KhachaturovIlya/Number-Generator/3Д/общий эскиз ГСЧ.pdf

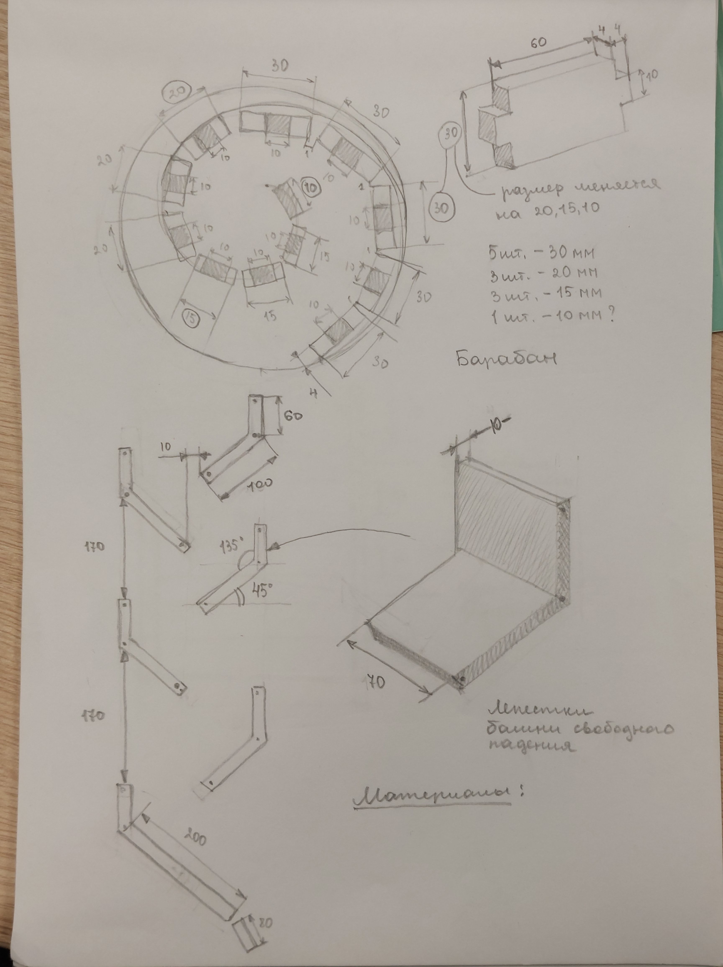
[picture p1: page 1]
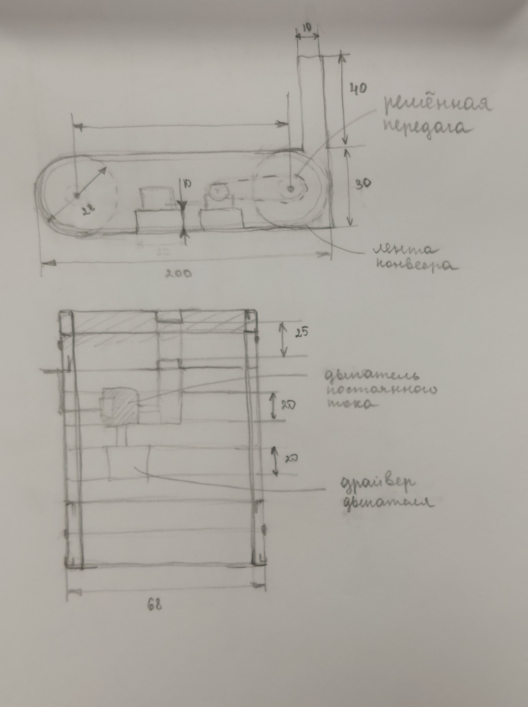
[picture p2: page 2]
