KhachaturovIlya/Number-Generator/3Д/Рендер барабана.pdf

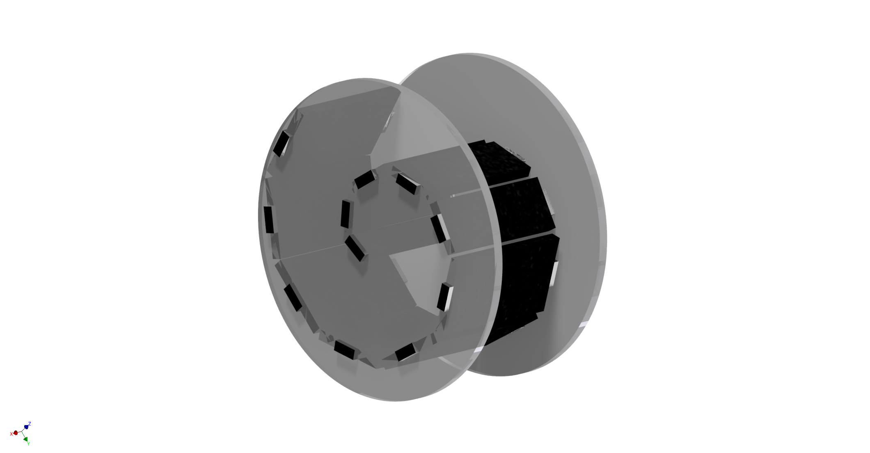
[picture p3: page 1]
