KhachaturovIlya/Number-Generator/3Д/Рендер конвейера в разрез.pdf

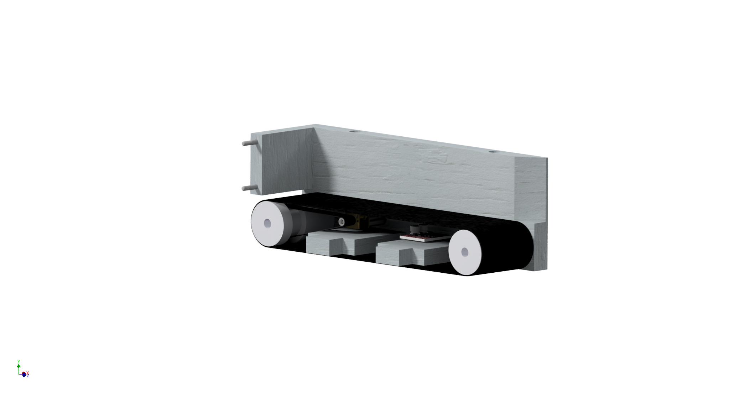
[picture p4: page 1]
