KhachaturovIlya/Number-Generator/3Д/Рендер конвейера.pdf

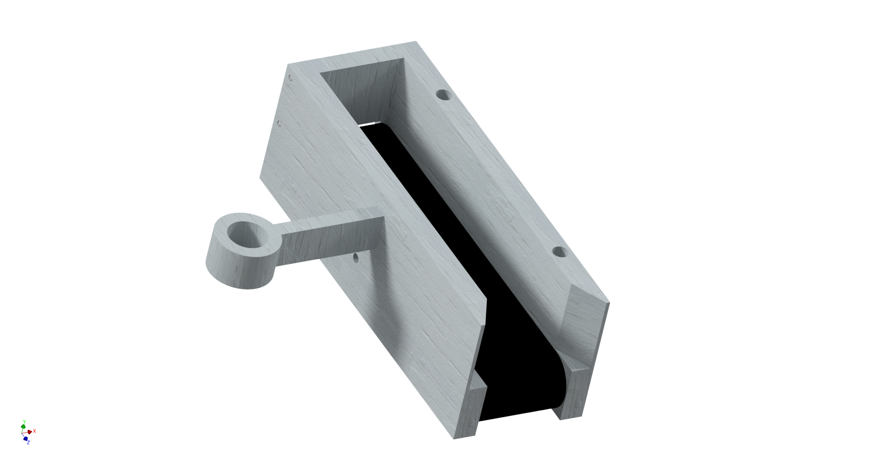
[picture p5: page 1]
