KhachaturovIlya/Number-Generator/3Д/рендер общий.pdf

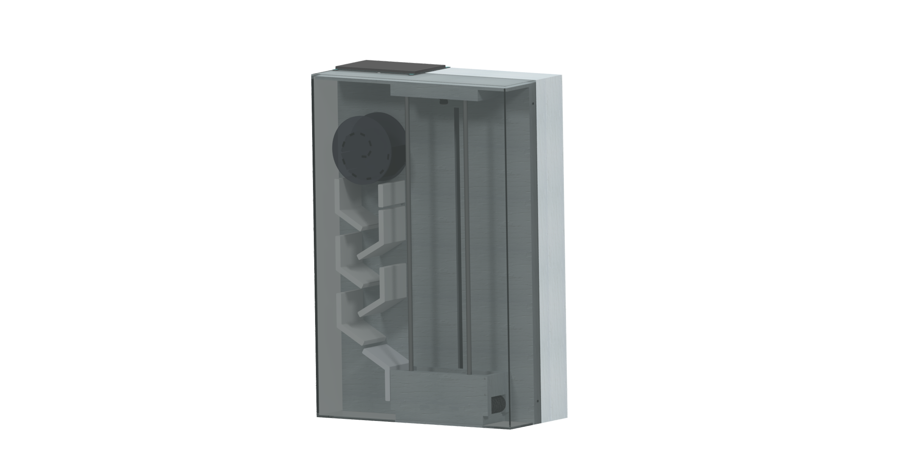
[picture p6: page 1]
