KhachaturovIlya/Number-Generator/3Д/рендер подъёма.pdf

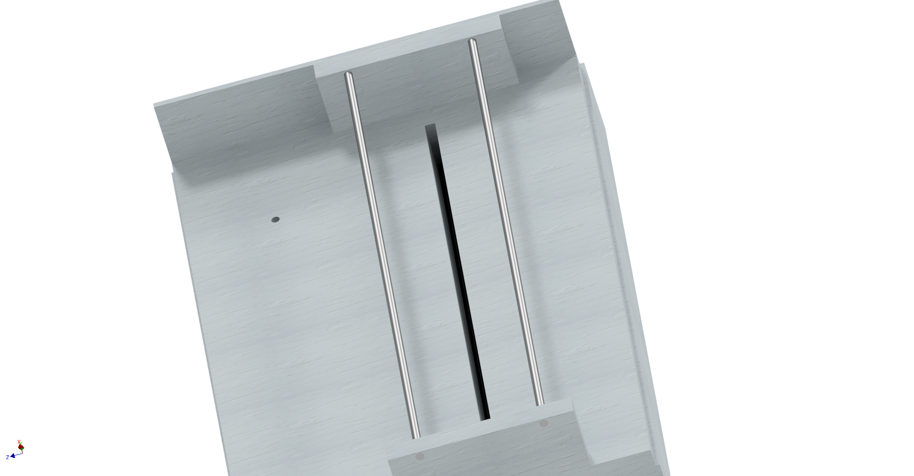
[picture p7: page 1]
