KhachaturovIlya/Number-Generator/3Д/Рендер шагового двигателя на подъём.pdf

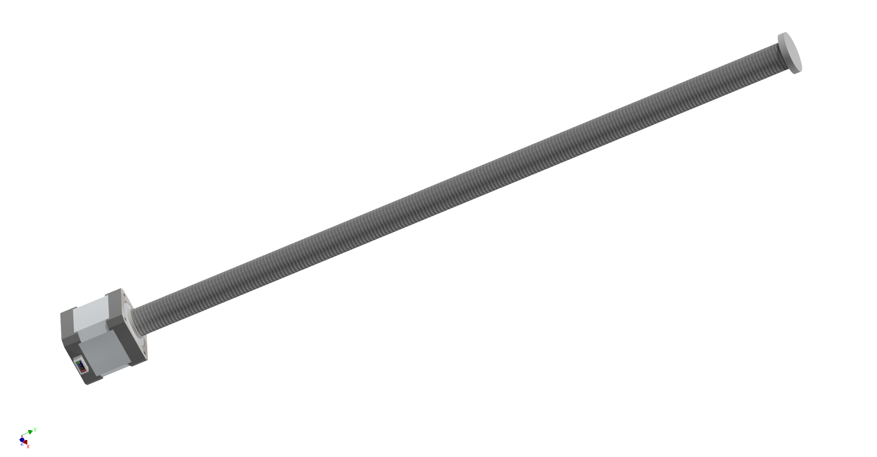
[picture p8: page 1]
