KhachaturovIlya/Number-Generator/3Д/Рендер элемента свободного падения.pdf

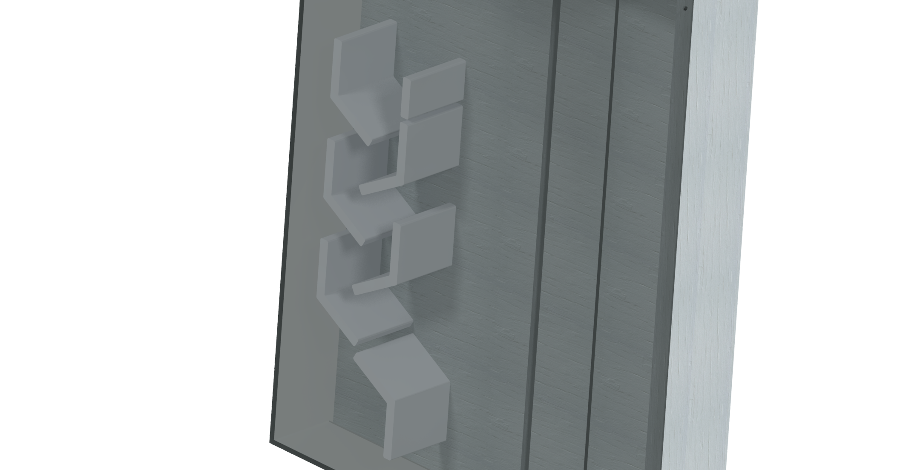
[picture p9: page 1]
