KhachaturovIlya/Number-Generator/Электро/Принципиальная схема, генератор случайных чисел.pdf

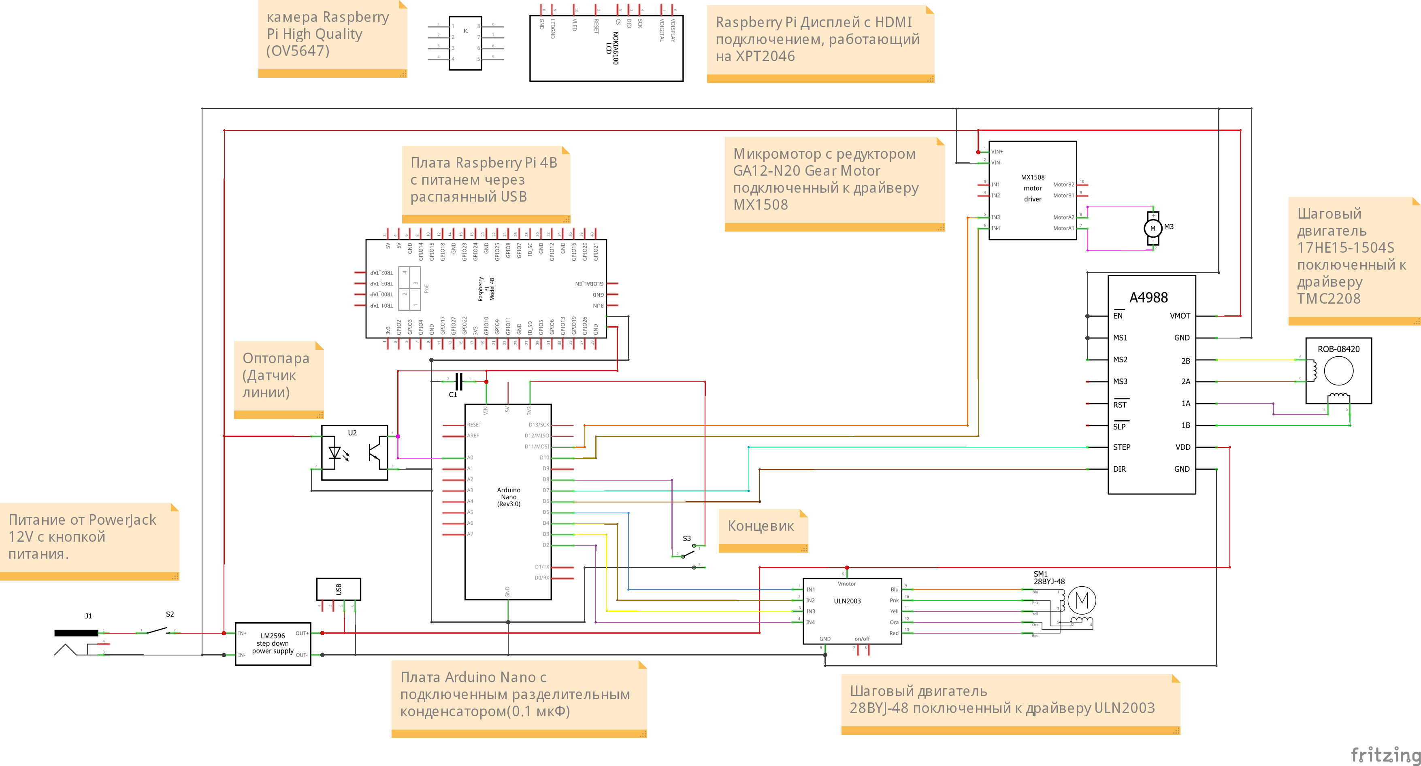
[picture p10: page 1]
