KhachaturovIlya/Number-Generator/По/Sequense.pdf

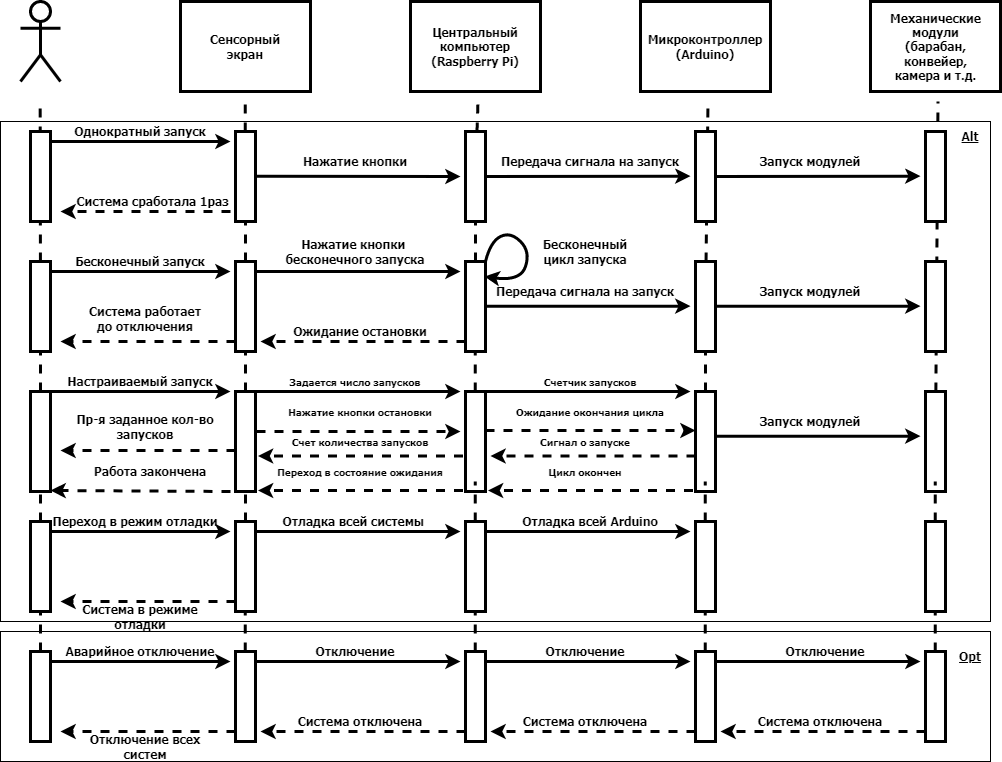
[picture p14: page 1]
