KhachaturovIlya/Number-Generator/По/State machine.pdf

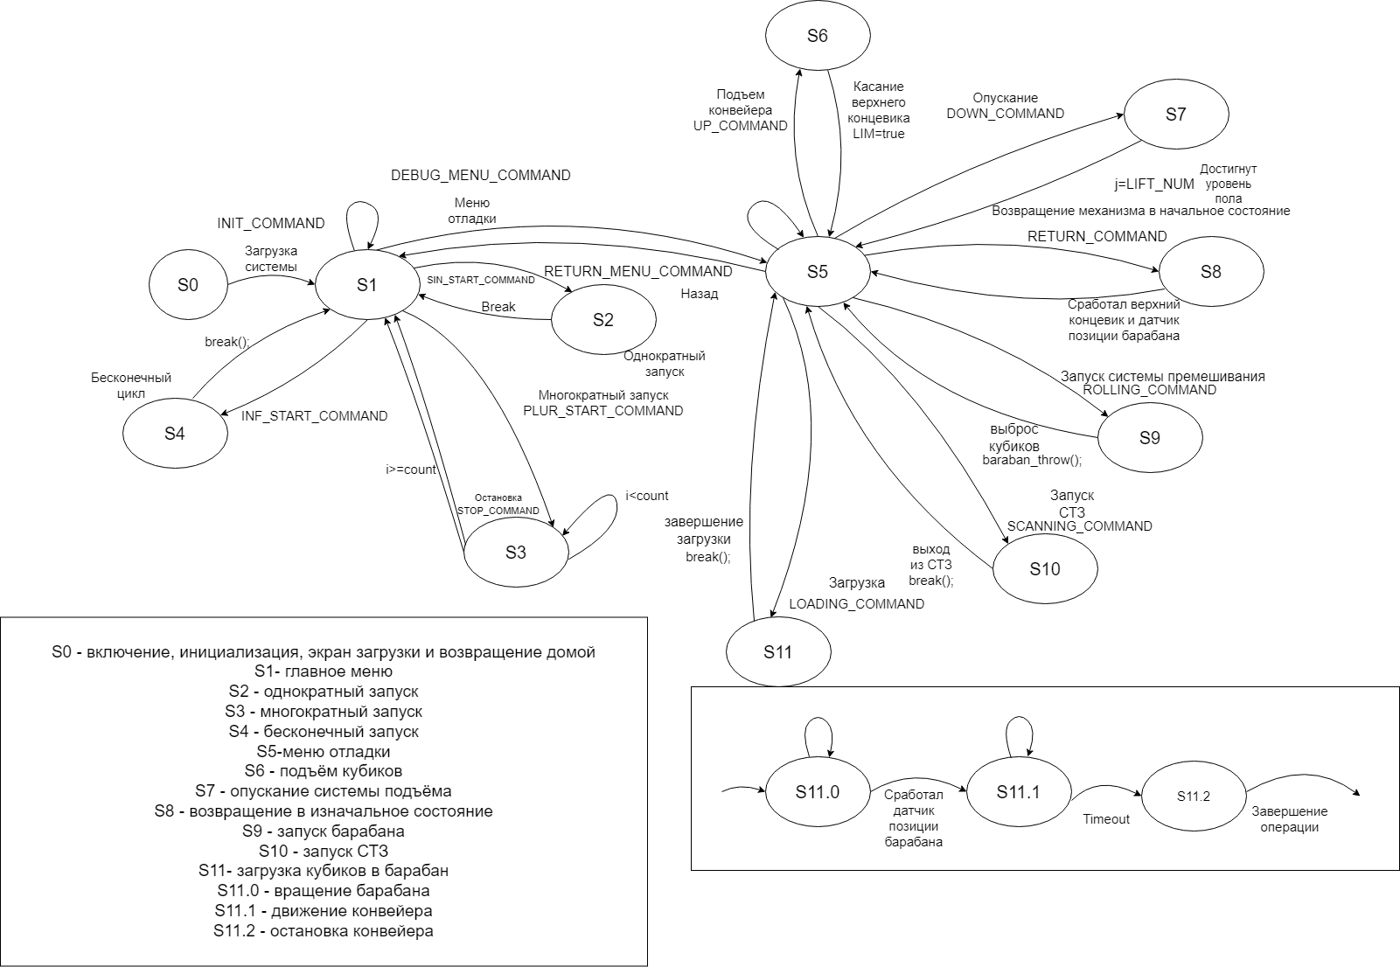
[picture p15: page 1]
