KhachaturovIlya/Number-Generator/По/Usecase 1.pdf

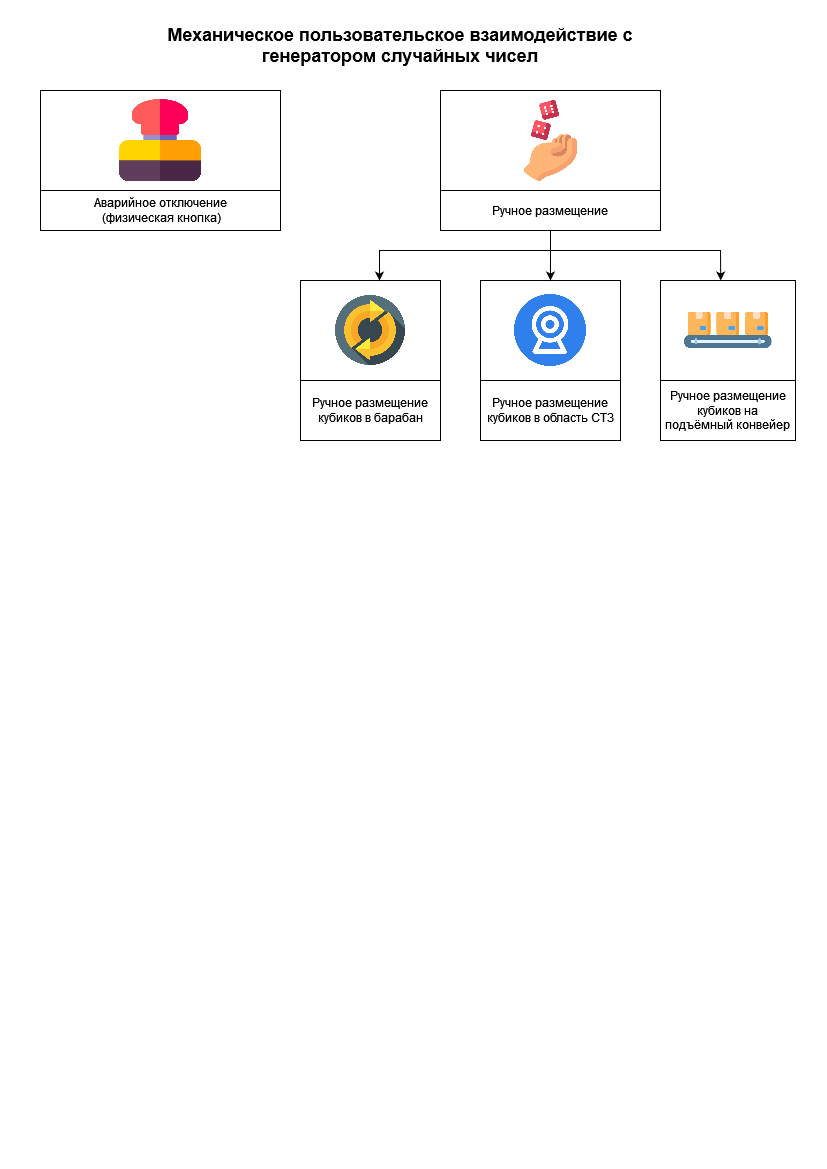
[picture p16: page 1]
