KhachaturovIlya/Number-Generator/По/Usecase2.pdf

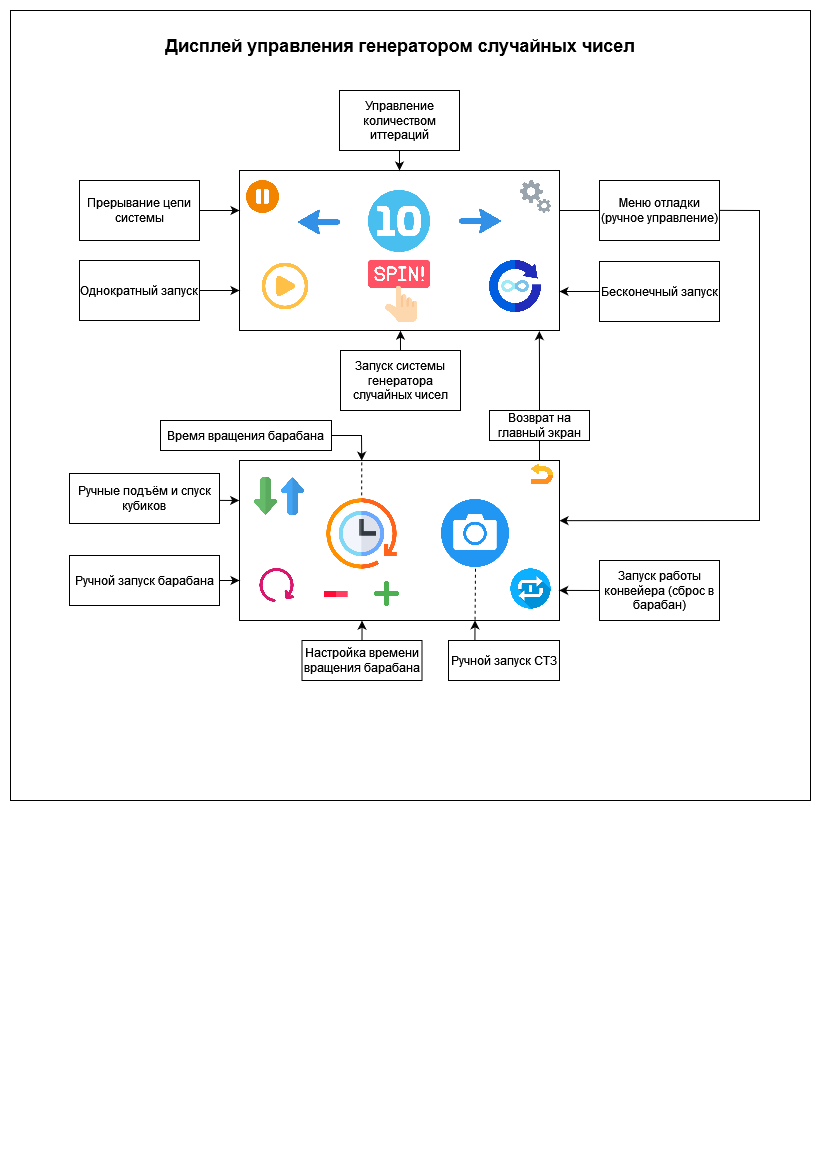
[picture p17: page 1]
