KhachaturovIlya/Number-Generator/По/Перечень пользовательского взаимодействия (1).pdf

1. Взаимодействия пользователя с дисплеем
1.1. Главный экран
1.1.1. Запуск однократного цикла выполнения итерации.
1.1.2. Запуск многократного цикла выполнения итераций в количестве заданном пользователем
1.1.3. Запуск бесконечного цикла выполнения итераций
1.1.4. Остановка цикла
1.1.5. Переход в меню отладки
1.2. Меню отладки
1.2.1. Выход из меню отладки
1.2.2. Ручной запуск системы технического зрения
1.2.3. Ручной запуск барабана
1.2.4. Ручные спуск и подъем кубиков
1.2.5. Настройка времени вращения в барабане
1.2.6. Ручной запуск кубиков на повторный круг
2. Взаимодействия пользователя с системой генератора случайных чисел.
2.1. Ручное размещение кубиков в область СТЗ
2.2. Ручное размещение кубиков в барабан
2.3. Ручное размещение кубиков на подъёмный конвейер
