KhachaturovIlya/Number-Generator/Электро/Монтажная схема, генератор случайных чисел.pdf

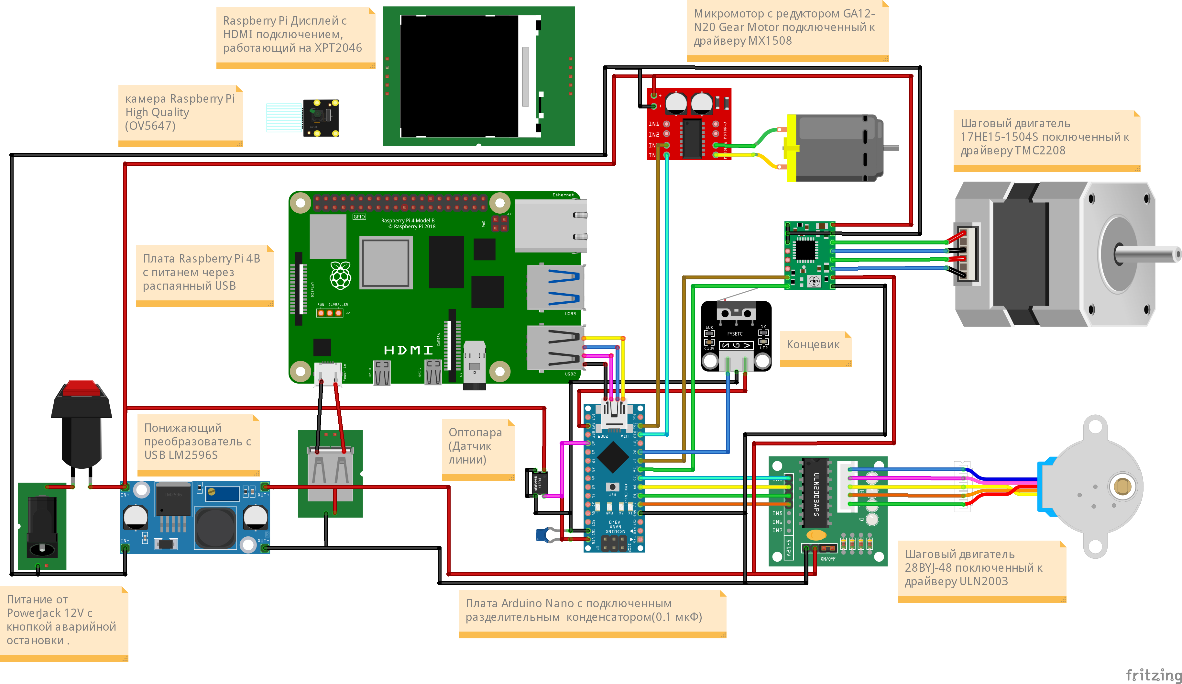
[picture p18: page 1]
