KhachaturovIlya/Number-Generator/3Д/Сборка всего (1).stp

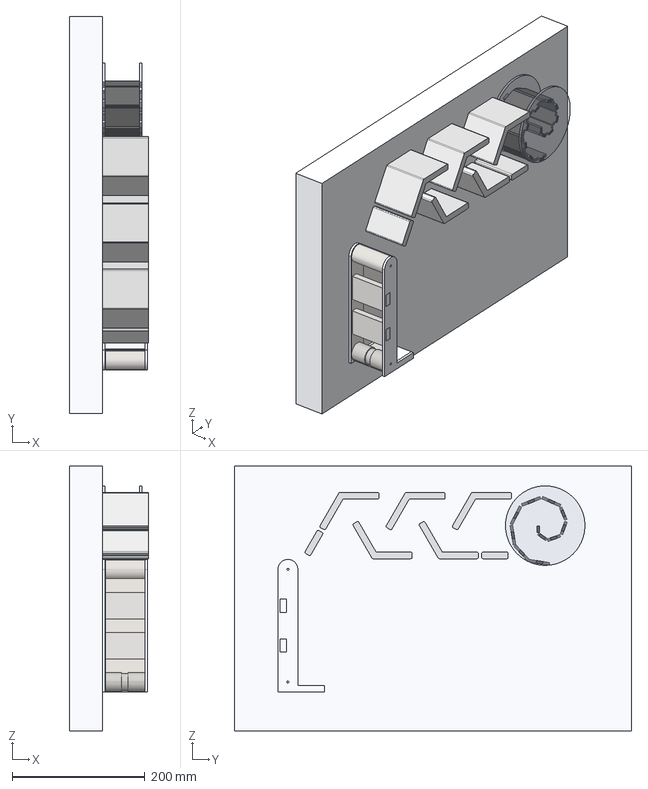
[picture p19: CAD file, 2023-02-20]
3Д/Сборка всего (1).stp
120.0 x 600.0 x 400.0 mm
Общий концепт в 3д
Стенка барабана x 2
Кусочек барабана на 3 см x 6
Кусочек барабана
Кусочек барабана_ 2 x 3
Кусочек барабана_ 1
Шпилька для Лепестков x 14
Лепесток БСП x 5
Стенка конвейера x 2
Вал конвейера
Вал конвейера 2
Подставка для двигателя и драйвера x 2
Стенкка для ковнейера
Лента конвейера
Стенка БСП_1 x 2
