KhachaturovIlya/Number-Generator/3Д/Сборка всего (2).stl

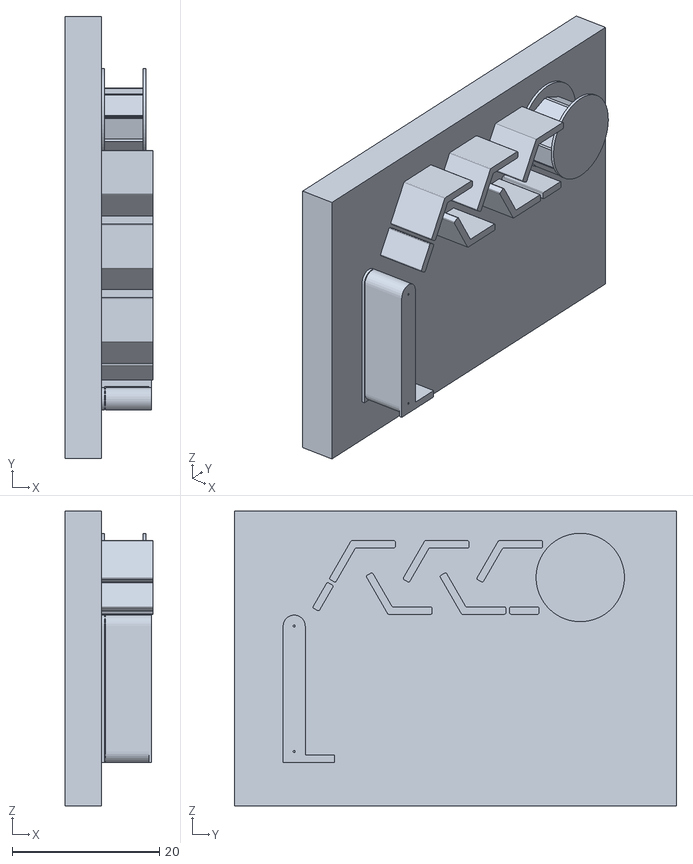
[picture p20: CAD file, 2023-02-20]
3Д/Сборка всего (2).stl
12.0 x 60.0 x 40.0
