KhachaturovIlya/Number-Generator/3Д/GA12-N20 Motor.STL

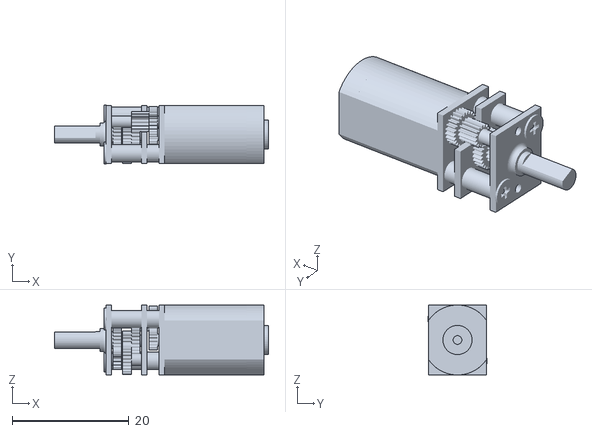
[picture p21: CAD file, 2023-02-20]
3Д/GA12-N20 Motor.STL
36.7 x 10.2 x 12.0
