KhachaturovIlya/Number-Generator/(list of files, cad)

Other CAD files:
3Д/Чертеж всей конструкции.dwg
3Д/Чертеж подъемного конвейера.dwg
3Д/Чертеж конвейера в разрезе.dwg
3Д/Чертеж все.dwg
3Д/Чертеж барабана.dwg
3Д/28BYJ-48 мотор.ipt
3Д/Apoio Contato.ipt
3Д/Base.ipt
3Д/Carcaça.ipt
3Д/Chapa Inferior.ipt
3Д/Chapa Intermediária.ipt
3Д/Chapa Superior.ipt
3Д/Contato.ipt
3Д/Display 7 Raspberry.ipt
3Д/Eixo - Encaixe D.ipt
3Д/Eixo Maior - Engrenagem.ipt
3Д/Eixo Menor - Engrenagem.ipt
3Д/Eixo Médio - Engrenagem.ipt
3Д/Escovas.ipt
3Д/Imãs.ipt
3Д/MX1508.ipt
3Д/Motor - Completo.iam
3Д/Motor M.ipt
3Д/Motor.iam
3Д/NEMA17_STEPPER.ipt
3Д/Ov5647 камера.ipt
3Д/Parafuso.ipt
3Д/Roda - Estrutura.ipt
3Д/Roda - Fixador de eixo.ipt
3Д/Roda - Pneu.ipt
3Д/Roda.iam
3Д/Rotor.ipt
3Д/Suporte Bobinas.ipt
3Д/Suporte Contato.ipt
3Д/Suporte Externo - Motor.ipt
3Д/Terminais.ipt
3Д/Барабан сборка (2).iam
3Д/Вал конвейера (1).ipt
3Д/Вал конвейера 2 (1).ipt
3Д/Задняя стенка.ipt
3Д/Конвейр без шпилек сборка.iam
3Д/Конвейр сборка (1).iam
3Д/Крепление для опор.ipt
3Д/Крепления и направляющие.iam
3Д/Кусочек барабана 10 мм (1).ipt
3Д/Кусочек барабана 15 мм (1).ipt
3Д/Кусочек барабана 20 мм (1).ipt
3Д/Кусочек барабана 30 мм (1).ipt
3Д/Лента конвейера (1).ipt
3Д/Лепестки со шпильками сборка (1).iam
3Д/Лепесток БСП (1).ipt
3Д/Механизм подъема.iam
3Д/Общий концепт в 3д (1).ipt
3Д/Опора подъемника.ipt
3Д/Подставка_для_двигателя_и_драйвера (1).ipt
3Д/Резьбовой винт.ipt
3Д/Ременная передача.ipt
3Д/Сборка всего (1).iam
3Д/Стеклянная крышка.ipt
3Д/Стенка БСП (1).iam
3Д/Стенка БСП (1).ipt
3Д/Стенка барабана (1).ipt
3Д/Стенка конвейера задняя.ipt
3Д/Стенка конвейера пердняя.ipt
3Д/Стенкка для ковнейера (1).ipt
3Д/Шкив для ДПТ.ipt
3Д/Шпилька скрепления деталей.ipt
3Д/Шпилька_крепления_к_несущеф_стене.ipt
