KhachaturovIlya/Number-Generator/(list of files, drawings)

Other design files:
Электро/Схема(генератор случайных чисел).fzz
